kiwisincebirth/TRS-80-KB/images/IMG_0691.jpeg

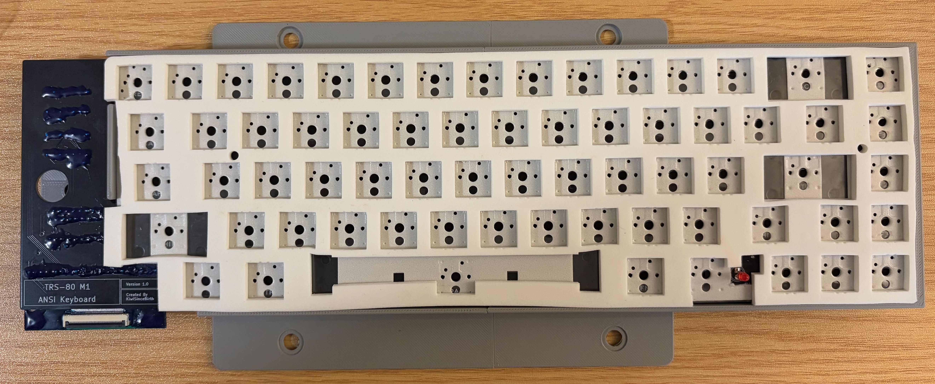
images/IMG_0691.jpeg
