kiwisincebirth/TRS-80-KB/pcb/TRS80_Model_I_ANSI_KB_BOM.csv

Reference | Value | Datasheet | Footprint | Description | Qty | DNP
C1,C2,C3 | 0.1uF | ~ | Capacitor_THT:C_Disc_D4.7mm_W2.5mm_P5.00mm | Capacitor 100nf Disk ThruHole P5mm | 3
CR1 | RED 5mm | ~ | LED_THT:LED_D5.0mm | LED 3mm_P2.54mm | 1
J1 | Connection Keyboad Side | ~ | Connector_PinHeader_2.54mm:PinHeader_1x20_P2.54mm_Vertical | PinHeader_1x20_P2.54mm | 1
R1 | 4.7k | http://www.vishay.com/docs/31509/csc.pdf | Resistor_THT:R_Array_SIP9 | Resistor 4K7 Array ThruHole SIP9 | 1
R2 | 330 | ~ | Resistor_THT:R_Axial_DIN0207_L6.3mm_D2.5mm_P7.62mm_Horizontal | Resistor 300 1/4w ThruHole Axial | 1
SW2,SW3,SW4,SW5,SW6,SW7,SW8,SW9,SW10,SW11,SW12,SW13,SW14,SW15,SW16,SW17,SW18,SW19,SW20,SW21,SW22,SW23,SW24,SW25,SW26,SW27,SW28,SW29,SW30,SW31,SW32,SW33,SW34,SW35,SW36,SW37,SW38,SW39,SW40,SW41,SW42,SW43,SW44,SW45,SW46,SW47,SW48,SW49,SW50,SW51,SW52,SW53,SW60,SW61,SW62,SW64,SW68,SW75,SW76 | ',,,-,.,/,0,1,2,3,4,5,6,7,8,9,;,=,A,B,BREAK,BS,C,CAPS,CLEAR,D,DOWN,E,ENTER,F,G,H,I,J,K,L,LEFT,LSHIFT,M,N,O,P,Q,R,RIGHT,RSHIFT,S,SPACE,T,TAB,U,UP,V,W,X,Y,Z,[,\,] | ~ | PCM_Switch_Keyboard_Hotswap_Kailh:SW_Hotswap_Kailh_MX_1.00u,PCM_Switch_Keyboard_Hotswap_Kailh:SW_Hotswap_Kailh_MX_1.50u,PCM_Switch_Keyboard_Hotswap_Kailh:SW_Hotswap_Kailh_MX_1.75u,PCM_Switch_Keyboard_Hotswap_Kailh:SW_Hotswap_Kailh_MX_2.00u,PCM_Switch_Keyboard_Hotswap_Kailh:SW_Hotswap_Kailh_MX_2.25u,PCM_Switch_Keyboard_Hotswap_Kailh:SW_Hotswap_Kailh_MX_6.25u | Hotswap_Kailh_MX | 59
SW67,SW69,SW70,SW71,SW72 | CTRL,F1,F2,F3,FN | ~ | PCM_Switch_Keyboard_Hotswap_Kailh:SW_Hotswap_Kailh_MX_1.00u,PCM_Switch_Keyboard_Hotswap_Kailh:SW_Hotswap_Kailh_MX_1.25u | Hotswap_Kailh_MX | 5 | DNP
Z1,Z2 | 74LS05 | http://www.ti.com/lit/gpn/sn74LS05 | Package_DIP:DIP-14_W7.62mm | 74LS05 | 2
Z3 | 74LS240 | http://www.ti.com/lit/ds/symlink/sn74ls240.pdf | Package_DIP:DIP-20_W7.62mm | 74LS240 | 1
