kiwisincebirth/TRS-80-KB/parts/Keyboard Bezel V1.3mf

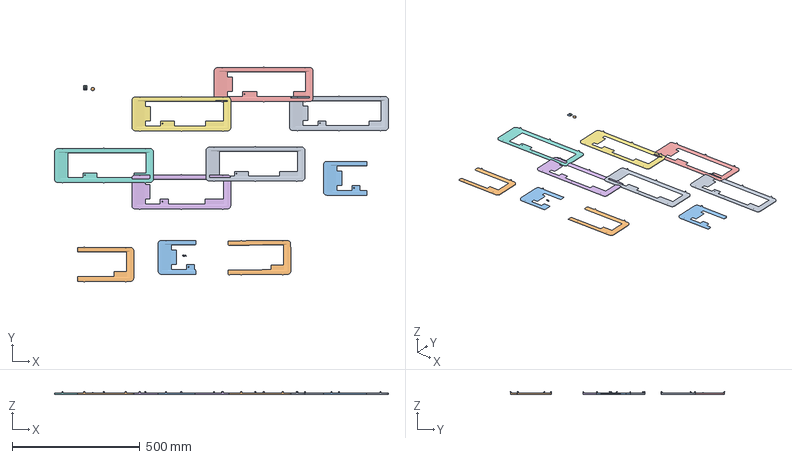
[picture p8: CAD file, 2026-11-10]
parts/Keyboard Bezel V1.3mf
1309.3 x 841.6 x 11.8 mm
BodyCtrlFn
ExampleDowel_A
ExampleDowel_B
Dowel-1
Dowel-2
Dowel-3
Dowel-4
Dowel-5
Dowel-6
LED-Difuser.stl
Clip1
Clip2
BodyCtrl
BodyFn
BodyStandard
BodyCtrlF123
BodyF123
ExampleDovetail_A
ExampleDovetail_B
