kiwisincebirth/TRS-80-KB/parts/Keyboard Base V1.3mf

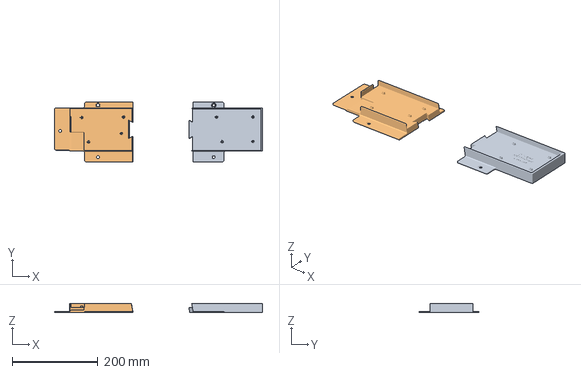
[picture p9: CAD file, 2026-11-07]
parts/Keyboard Base V1.3mf
486.0 x 140.2 x 22.1 mm
MainBody_A
MainBody_B
