kiwisincebirth/TRS-80-KB/BUILDING.md

# Build Assembly Guide

Before Assembly, you will need to purchase and source certain 
parts. Please See the separate [Component List](./COMPONENTS.md)
for the required parts.

## PCB

The first part of assembly is the PCB

Notes when assembling the PCB
* All the components (except the power LED) are soldered to the back of the PCB.
* The power LED is considered optional, it can be omitted if not required.
* If using PCB mounted stabilisers (not in BOM) these need to be attached to the PCB.
* You can use IC sockets (or not) based on your preference.

I suggest using the FFC ribbon cable to attach the keyboard to the main board,
but a standard 20 pin header can also be used. Neither of these is in the BOM

#### Front

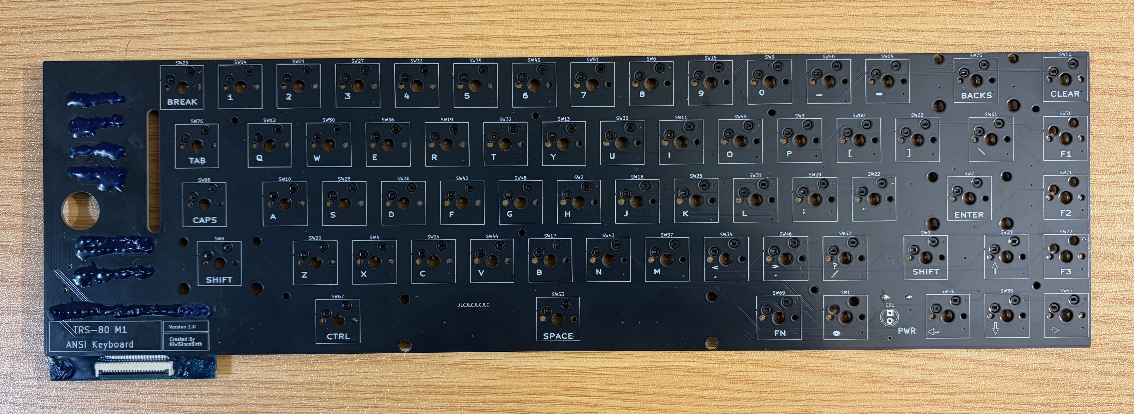
[picture p10: images/IMG_0658.jpeg]


#### Back

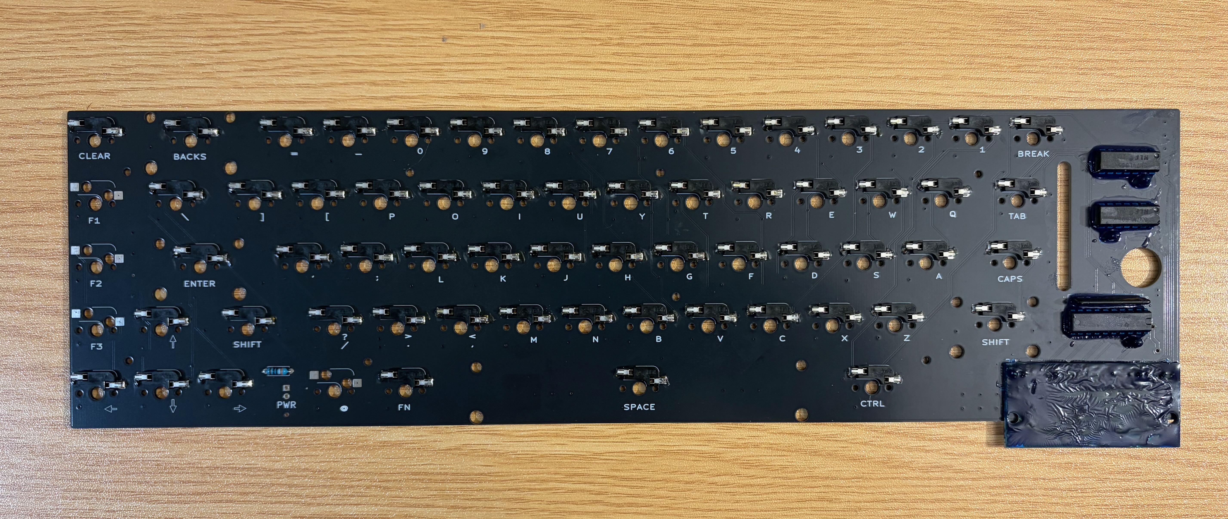
[picture p11: images/IMG_0657.jpeg]


Once assembled the keyboard PCB can be tested by inserting a couple of keyswitches
and connecting to a Model 1. It doesnt need all the keyswitches to work.

## Internal Frame

[Keyboard Base 3MF](./parts/Keyboard%20Base%20V1.3mf)

The (3D Printed) internal base frame mounts to 5 keyboard case mount points,
and additionally it is supported from underneath by 3 central mounting posts.

The full internal frame cannot be printed on a typical size 3D Printer and
has been broken into 2 pieces using a connecting dovetail joint. You need 
need a bed size of 180mm to print these 2 halves.

The internal frame can be printed in any material (I used PLA), since the part
is quite thick, and well-supported in the case.

Once Printed you need to assemble the 2 parts together. 
The dovetail is tapered, and can only be joined in one way.
Ideally CA glue or epoxy should be used when joining the 2 parts.

Then 8x Brass M2 heat set inserts need to be installed into the frame.
These are for the for the PCB to be screwed to.

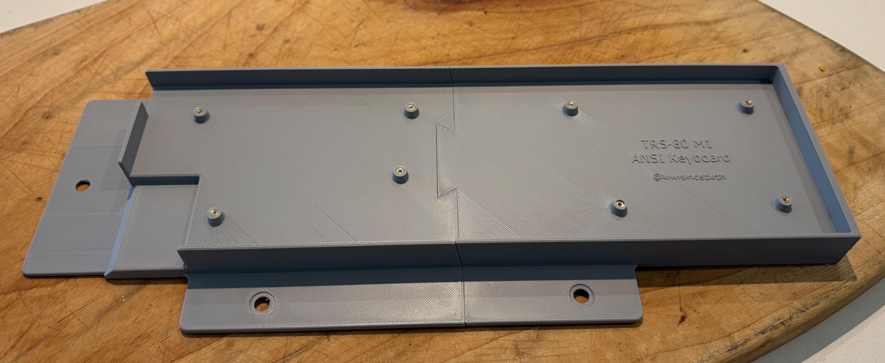
[picture p12: images/IMG_0687.jpeg]


## Main Assembly

Assembly of the keyboard is done in layers. 

When installing each layer you need to ensure that foam layers are
trimmed fit within the outline of the PCB, so the sit down inside 
the brim of the internal frame, and holes are added to allow 
PCB mounting screws to be used.

### Foam Layer Under PCB

In the donar keyboard the foam layer was stuck to PCB back using adhesive

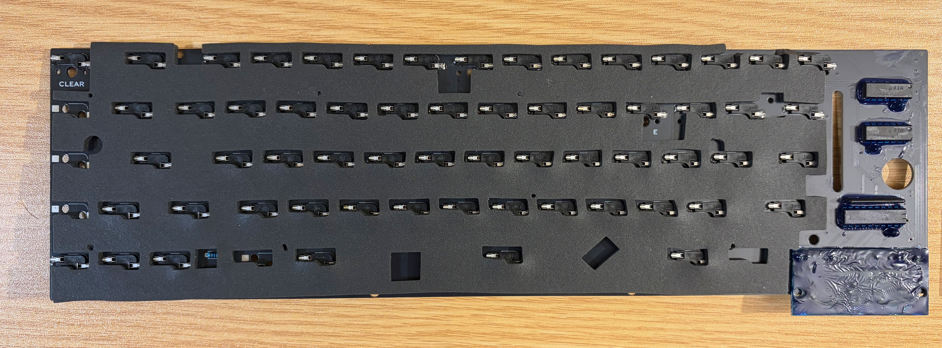
[picture p13: images/IMG_0665.jpeg]


### Main PCB

The main keyboard PCB itself, ensure it is fully assembled first. 
Use short M2 screws to attach the PCB to the internal frame.

When attaching the PCB to the frame (using M2 bolts), they should be very lightly
tightened. The screws are just to locate the PCB, leaving them loose will allow
The PCB to move, and improve sound quality.

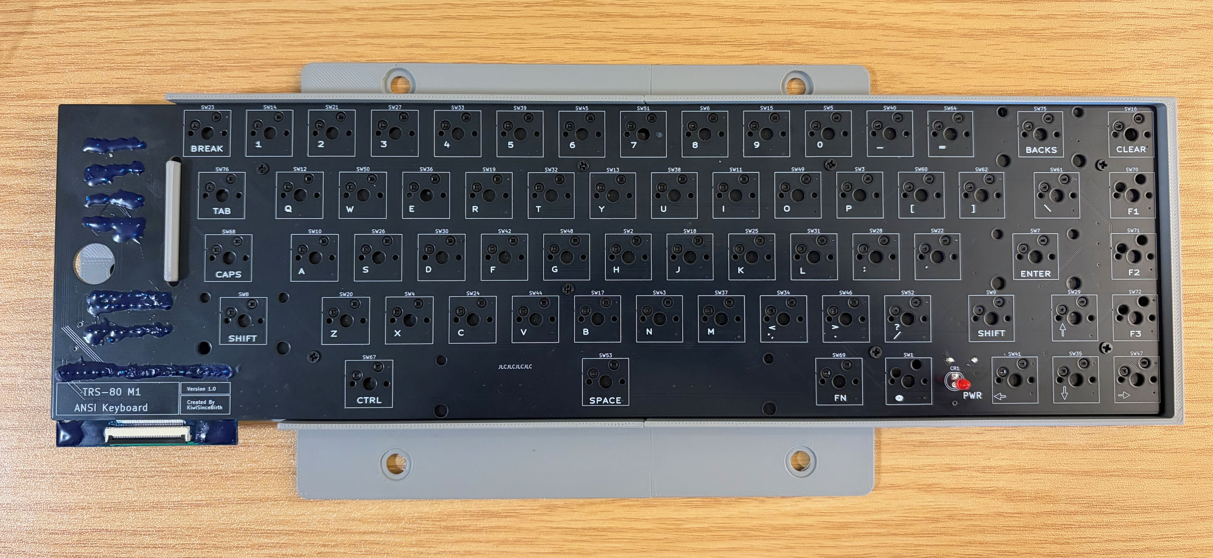
[picture p14: images/IMG_0689.jpeg]


### Thin Cotton

The cotton layers are to provide isolation from the PCB to the back of the Key switches
These layers need to be aligned to the individual key switch holes

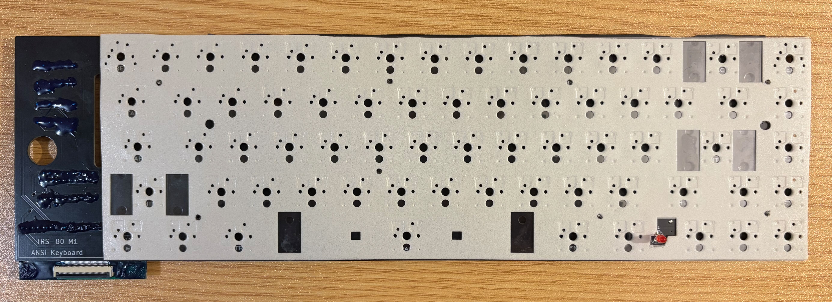
[picture p15: images/IMG_0666.jpeg]


### Key-switch Foam 

This is a thick main sound deadening foam layer which sit around the keyswitches

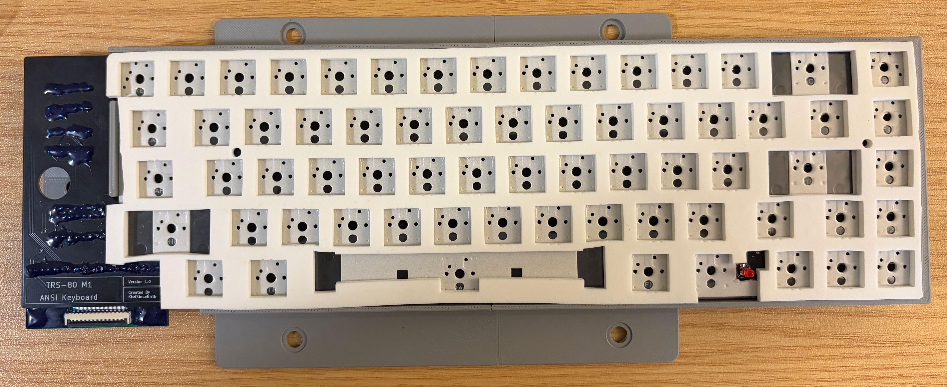
[picture p16: images/IMG_0690.jpeg]


### Keyboard Plate

The keyboard plate, including plate mounted key stabilisers (not shown).
This is the layer to provides the main support structure for the keyswitches

Surrounding the PCB area is a brim which the keyboard plate rests on.
This provides support to the keys via the plate, removing stress on the PCB.
While the plate rests on the brim, it should not extend over it, and may need to be trimmed.

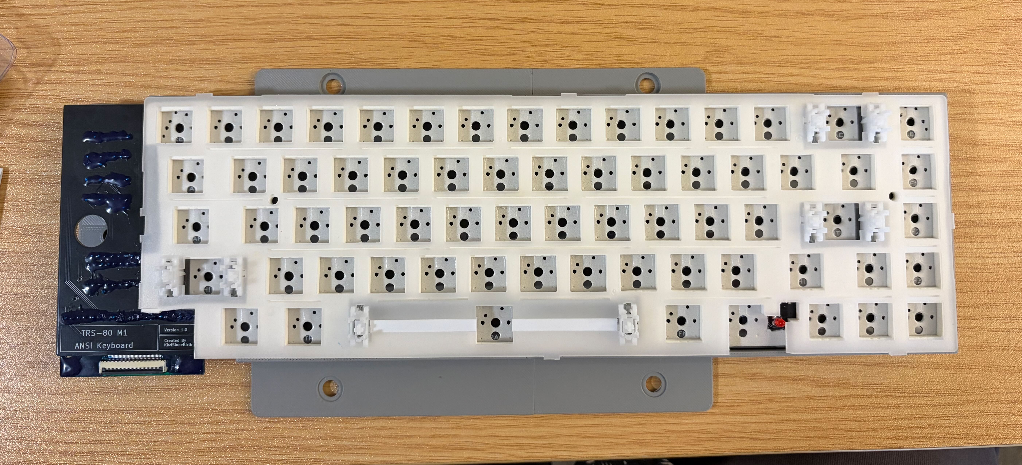
[picture p17: images/IMG_0692.jpeg]


A cutout in the plate may be needed to allow Power LED (if installed).

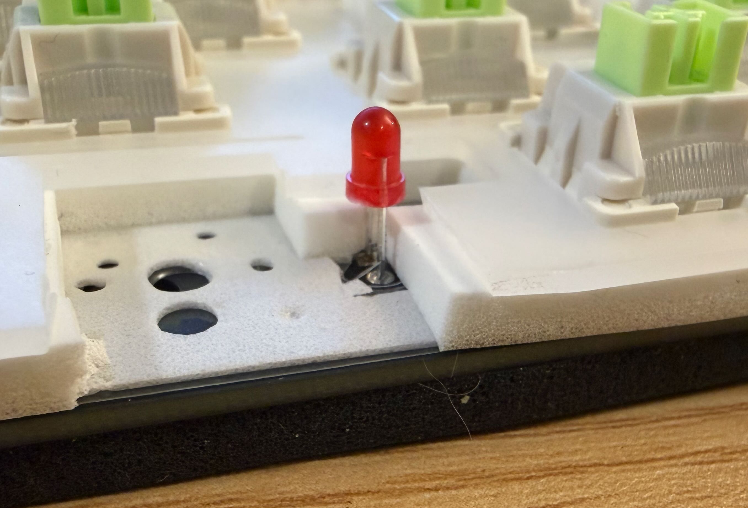
[picture p18: images/IMG_0682.jpeg]


### Keyswitches

Key switches installed through plate into sockets.
Key switches are required to secures the plate and the foam layers undeneath

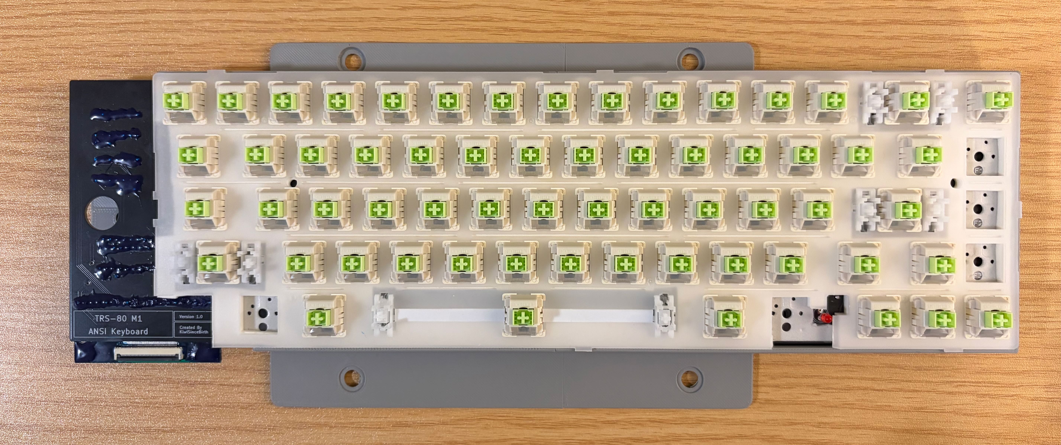
[picture p19: images/IMG_0694.jpeg]


### Keycaps

Finally, the Keycaps can be attached.

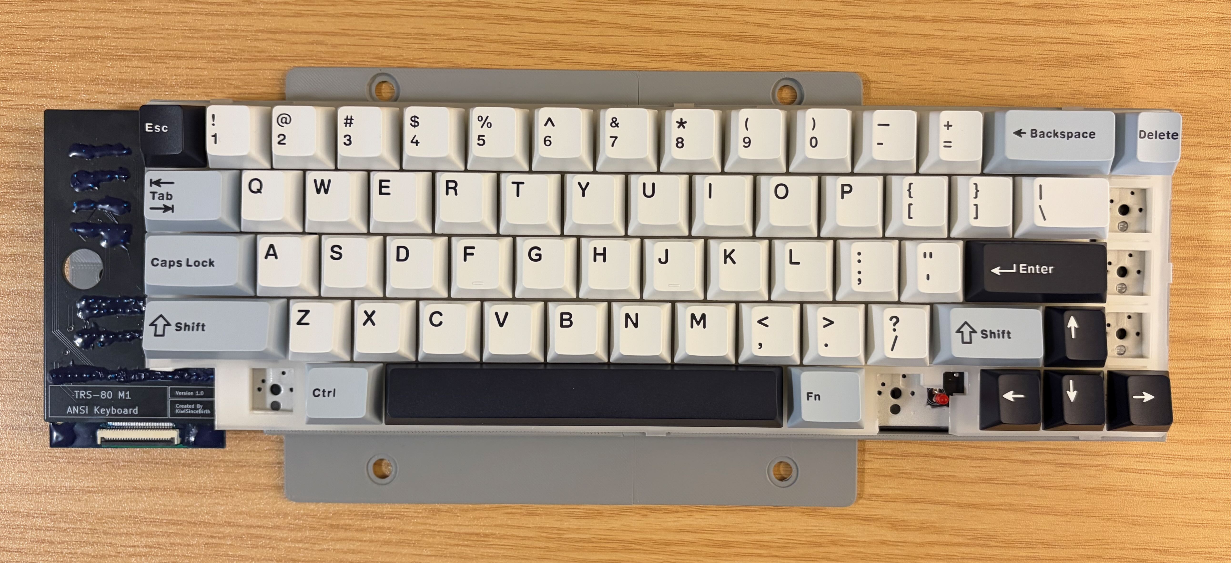
[picture p20: images/IMG_0696.jpeg]


### Completed Board

You should have something like this.

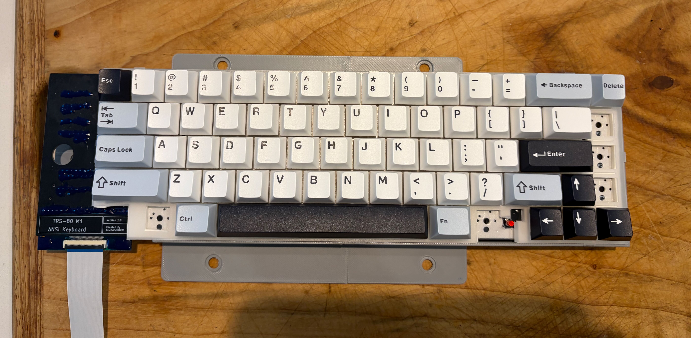
[picture p21: images/IMG_0701.jpeg]


## Bezel

[Keyboard Bezel 3MF](./parts/Keyboard%20Bezel%20V1.3mf)

The (3D Printed) bezel attaches to the other case surrounding the keyboard.
It has a different cutout matching the keyboard layout and 
a different aesthetic, to the traditional TRS-80 bezel.

There are six varients of the Bezel depending on the use of optional Keys.
This includes CTRL, FN, F1-F3. Please print the correct varient.

The Bezel cannot be printed on a typical size 3D Printer and
needs to be broken into 2 pieces and joined after printing. 
There are 2 examples of this, either using connecting Dowels, 
or using a Dovetail joint. You will need to cut this in your slicer. 

Printing is done without supports, with the top of the bezel facing the build plate,
this means you can achieve a pattern based on the texture of the build plate used.
Bezel can be printed in any material, I used Black PLA

Once Printed you need to assemble the 2 parts together.
